fedemille/RGB-STAGE-LIGHT/Media/IMG_20210901_003731_718-01.jpeg

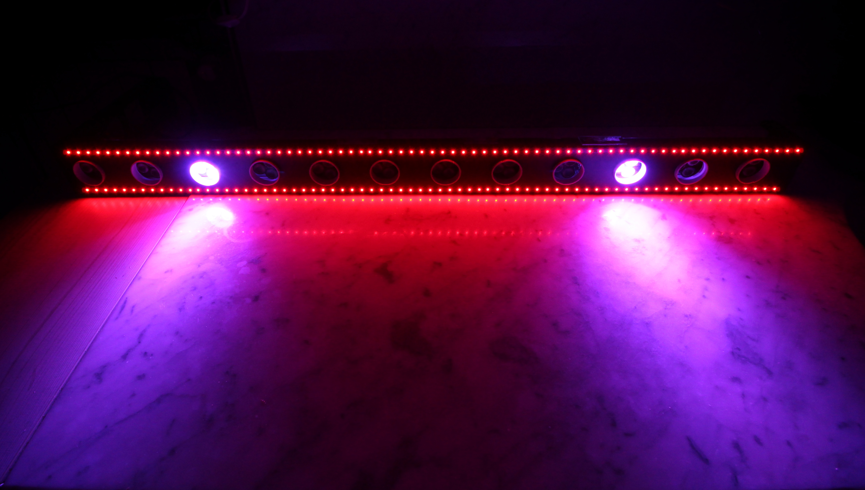
Media/IMG_20210901_003731_718-01.jpeg
