fedemille/RGB-STAGE-LIGHT/Media/IMG_20210825_105324.jpg

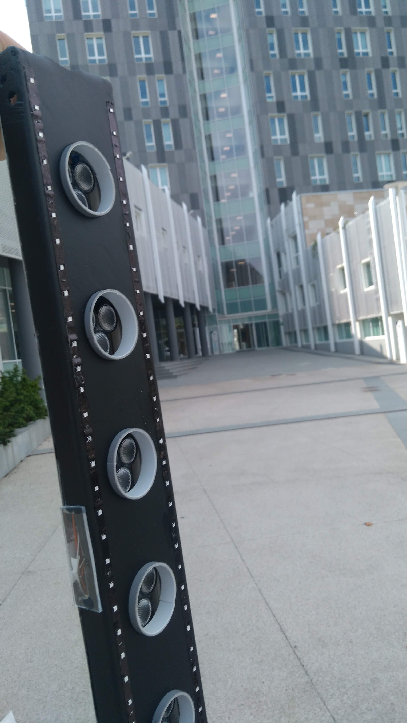
Media/IMG_20210825_105324.jpg
