fedemille/RGB-STAGE-LIGHT/Media/20210831231129_IMG_9081.JPG

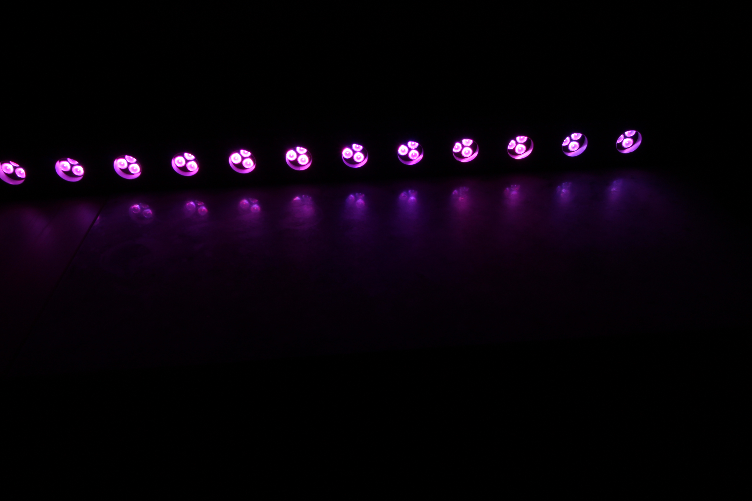
Media/20210831231129_IMG_9081.JPG
