fedemille/RGB-STAGE-LIGHT/Media/20210831231152_IMG_9084.JPG

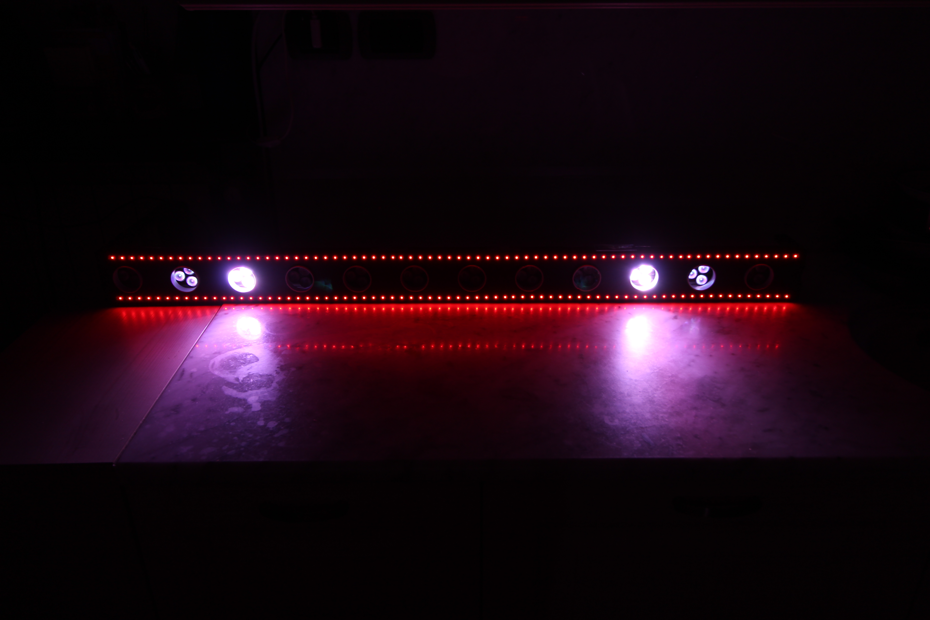
Media/20210831231152_IMG_9084.JPG
