fedemille/RGB-STAGE-LIGHT/Media/IMG_20210614_184518.jpg

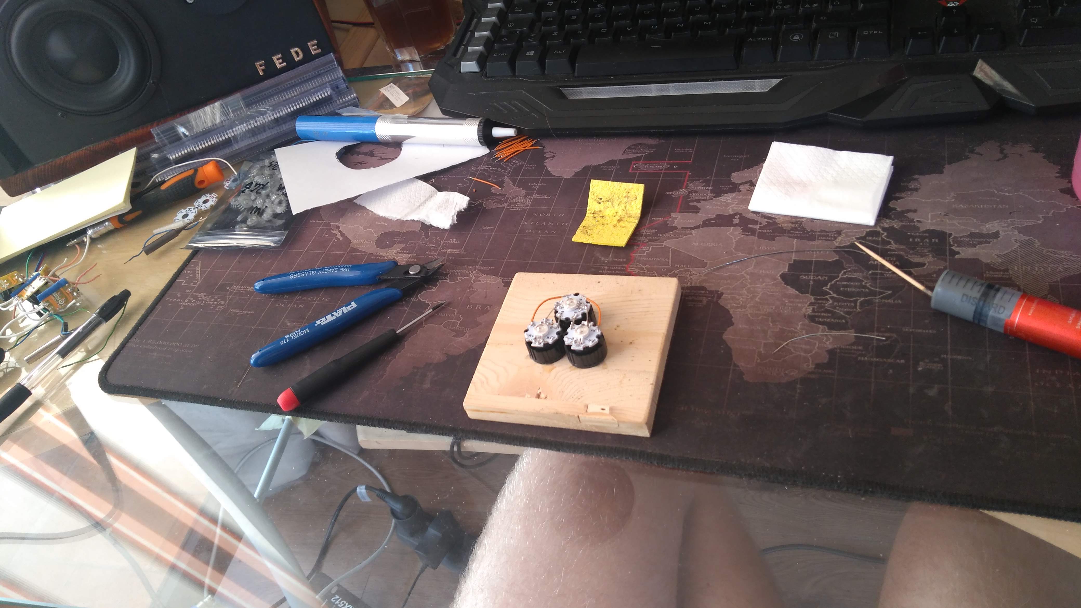
Media/IMG_20210614_184518.jpg
