fedemille/RGB-STAGE-LIGHT/Media/IMG_20210628_230511.jpg

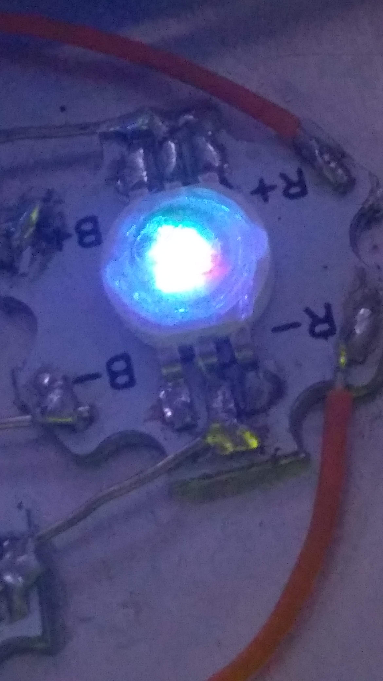
Media/IMG_20210628_230511.jpg
