fedemille/RGB-STAGE-LIGHT/Media/photo2.JPG

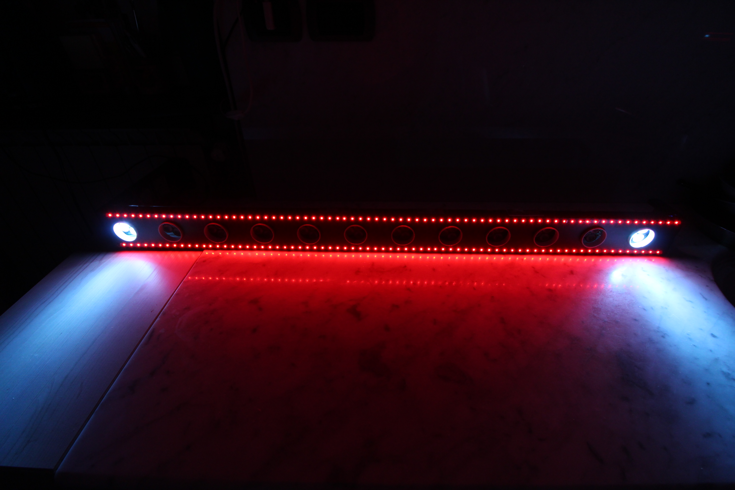
Media/photo2.JPG
